cmsivolella/WiCharge-doc/esquematico_adafruit.png

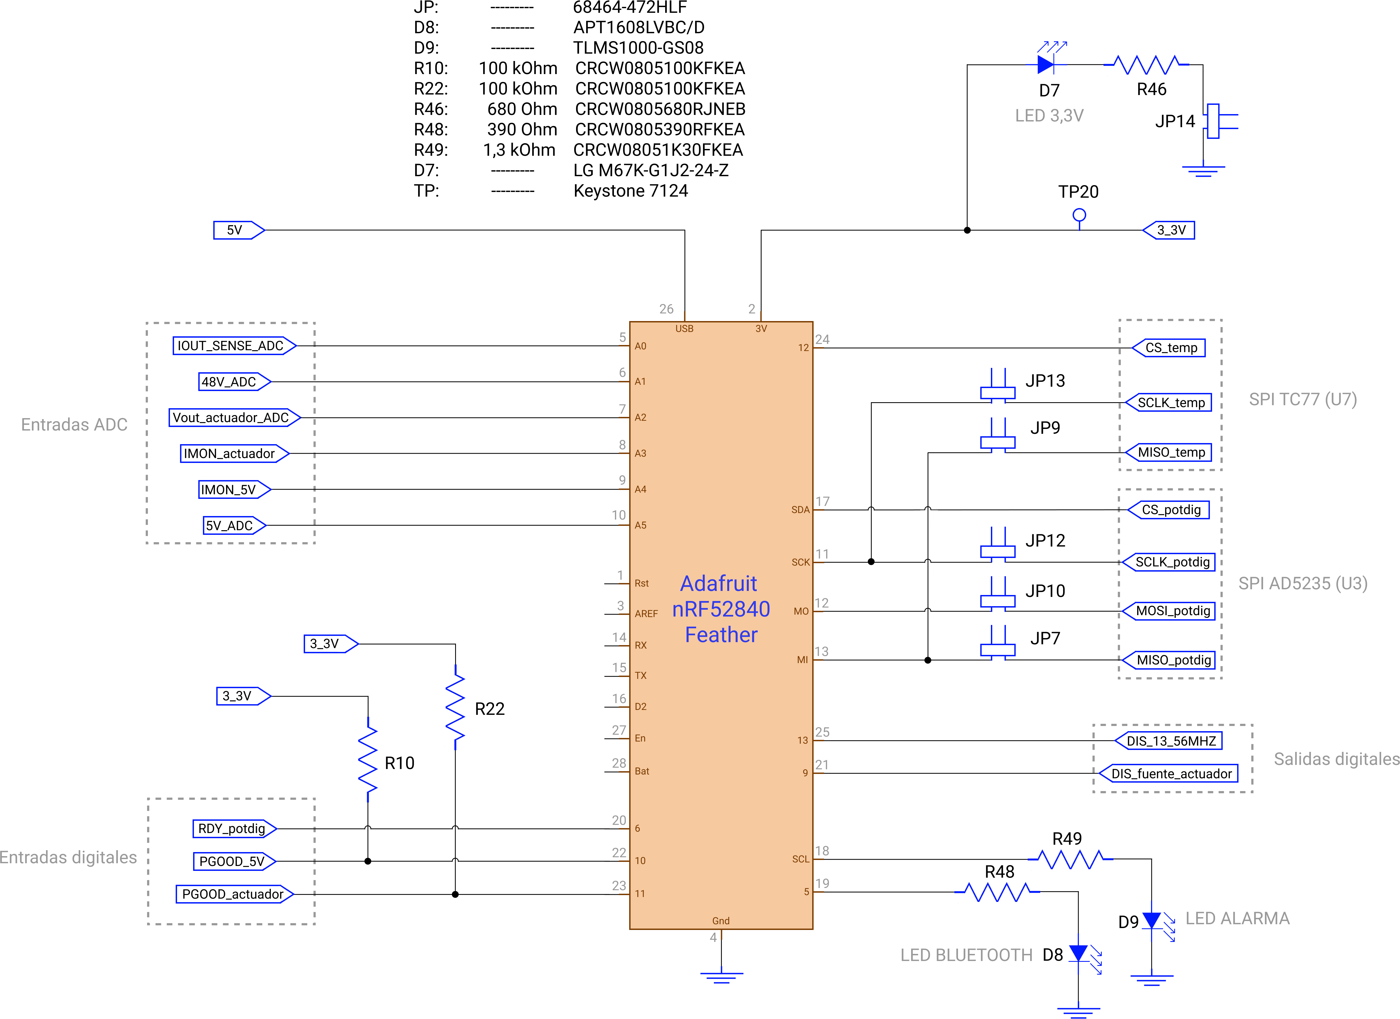
esquematico_adafruit.png
