cmsivolella/WiCharge-doc/esquematico_altonivel.png

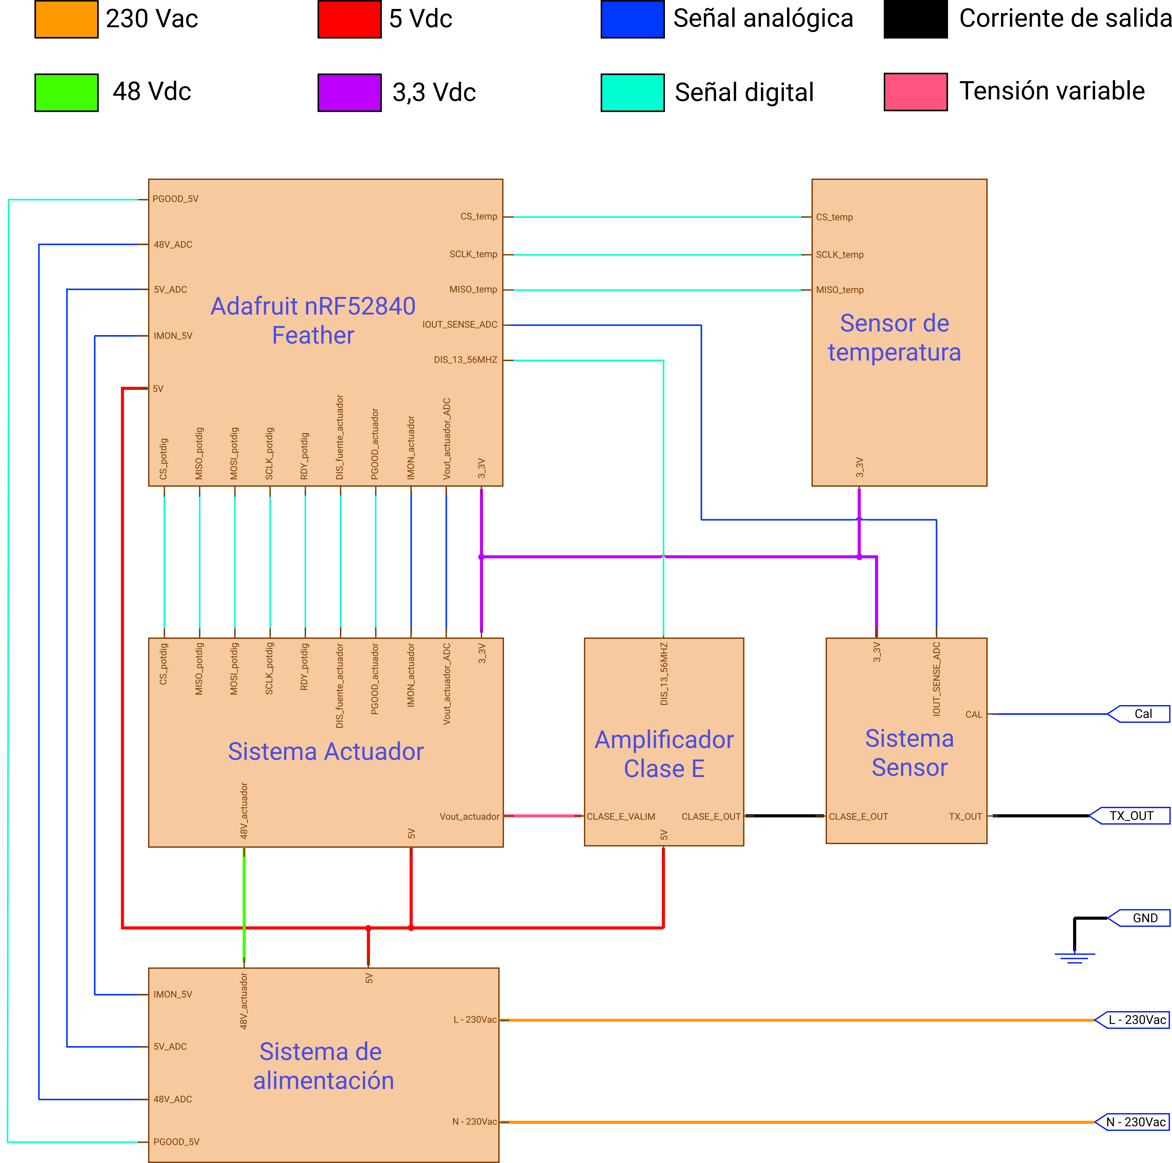
esquematico_altonivel.png
