cmsivolella/WiCharge-doc/esquematico_claseE.png

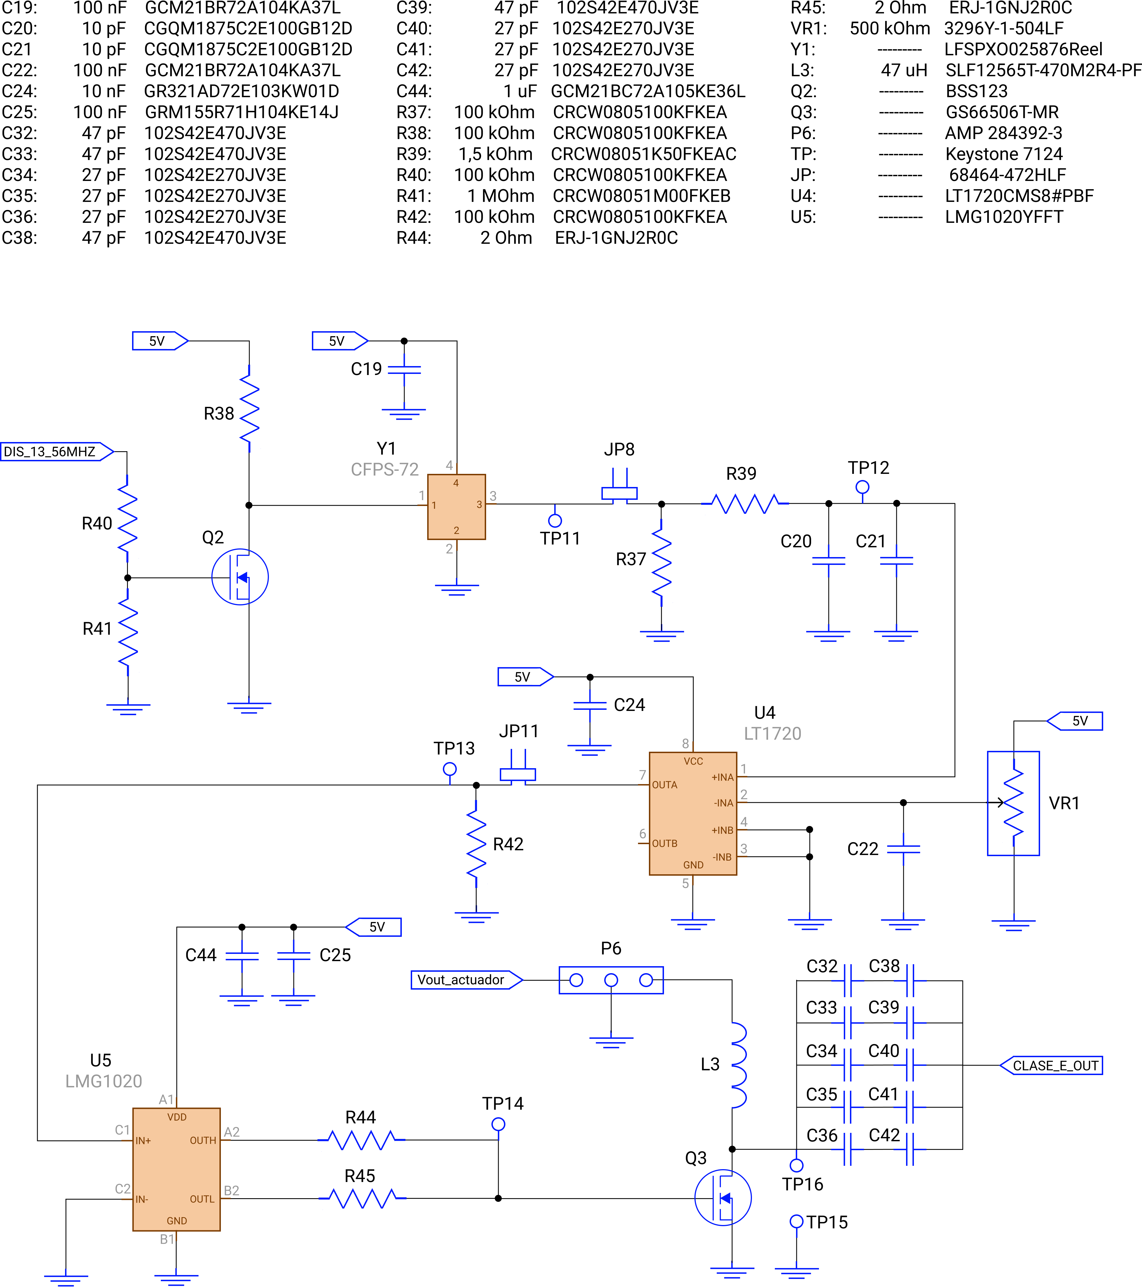
esquematico_claseE.png
