cmsivolella/WiCharge-doc/esquematico_sensortemperatura.png

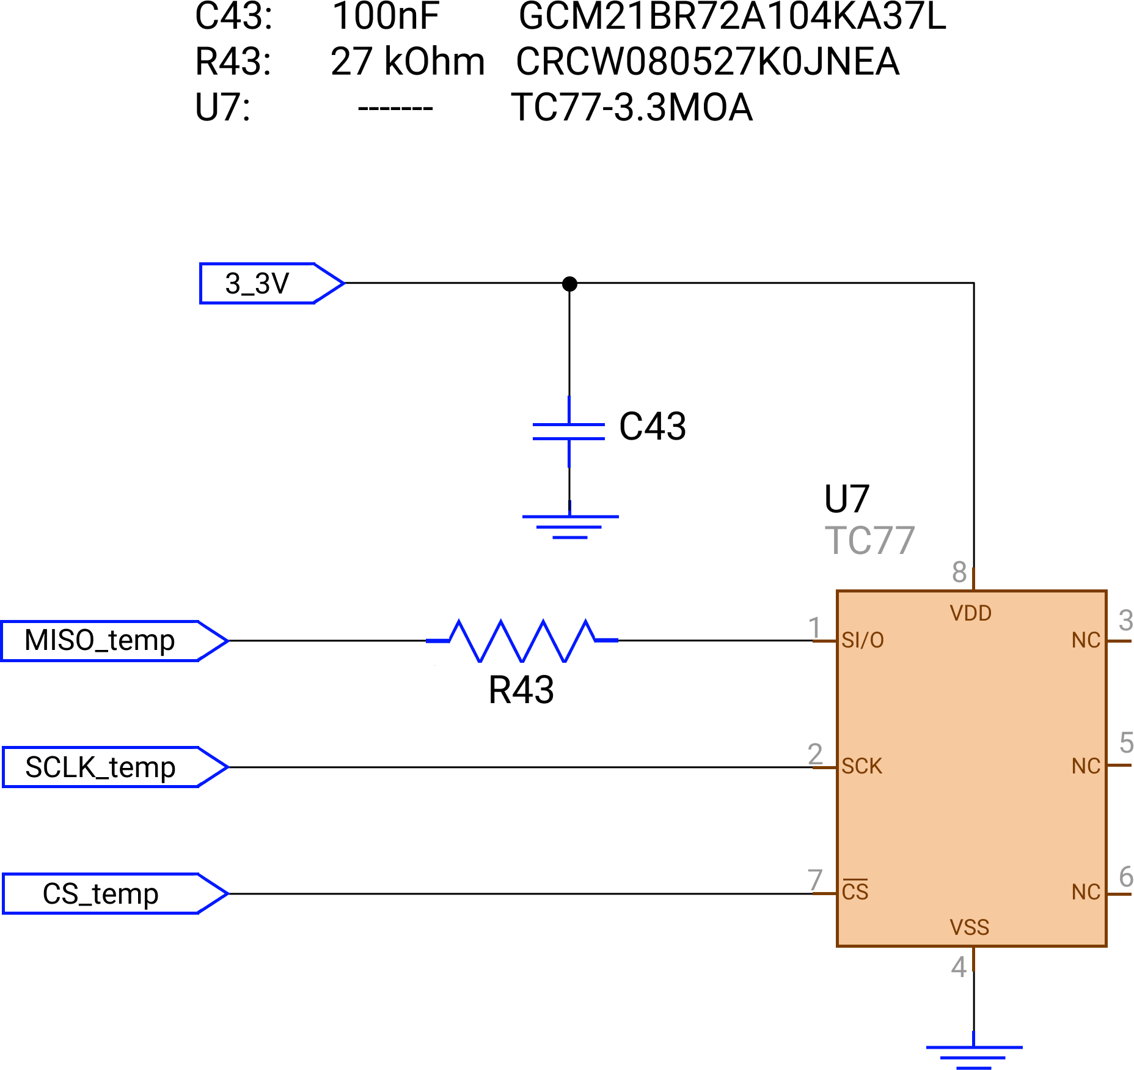
esquematico_sensortemperatura.png
