cmsivolella/WiCharge-doc/esquematico_sissensor_sincarga.png

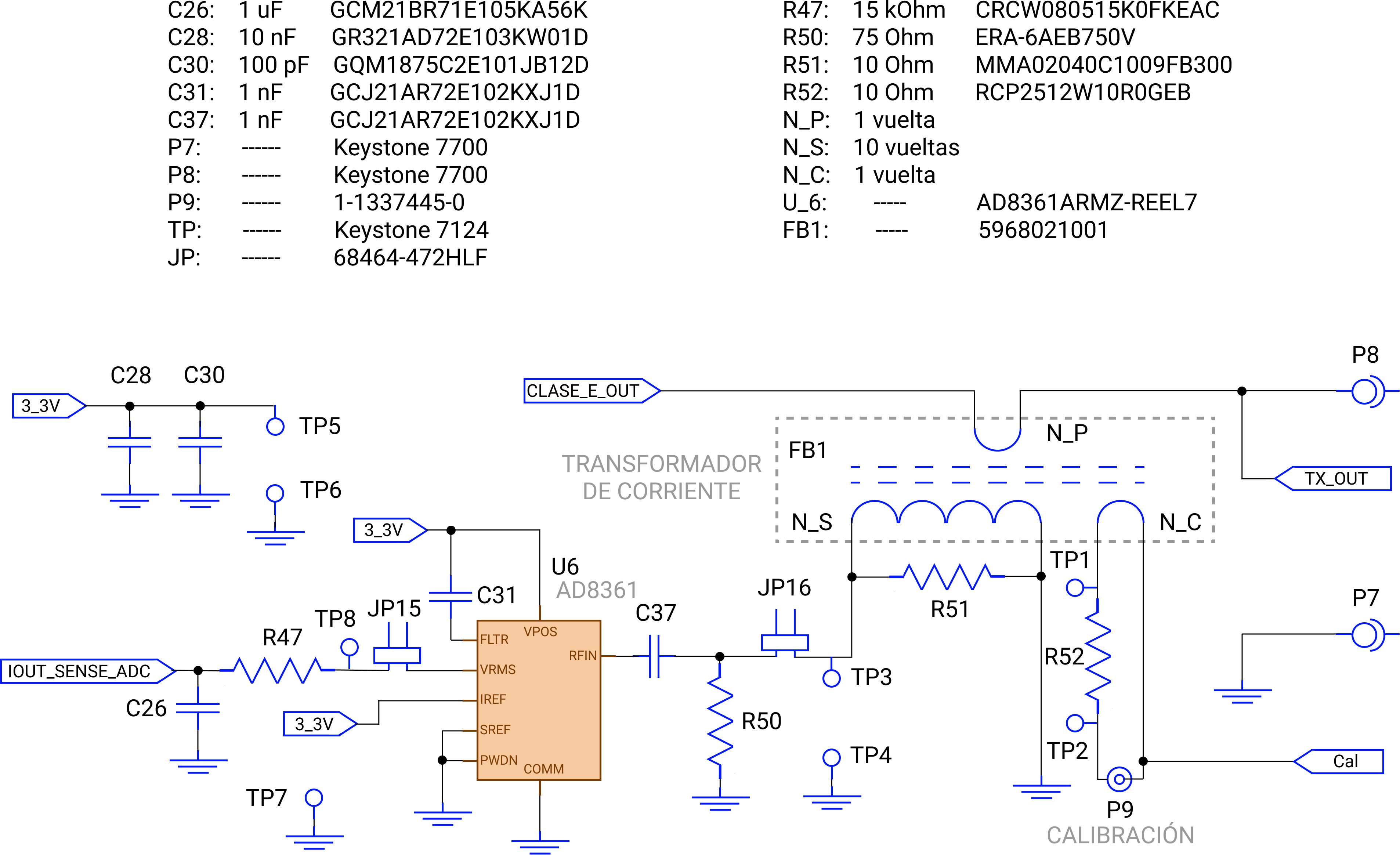
esquematico_sissensor_sincarga.png
