cmsivolella/WiCharge-doc/esquematicocompleto_alimentacion.png

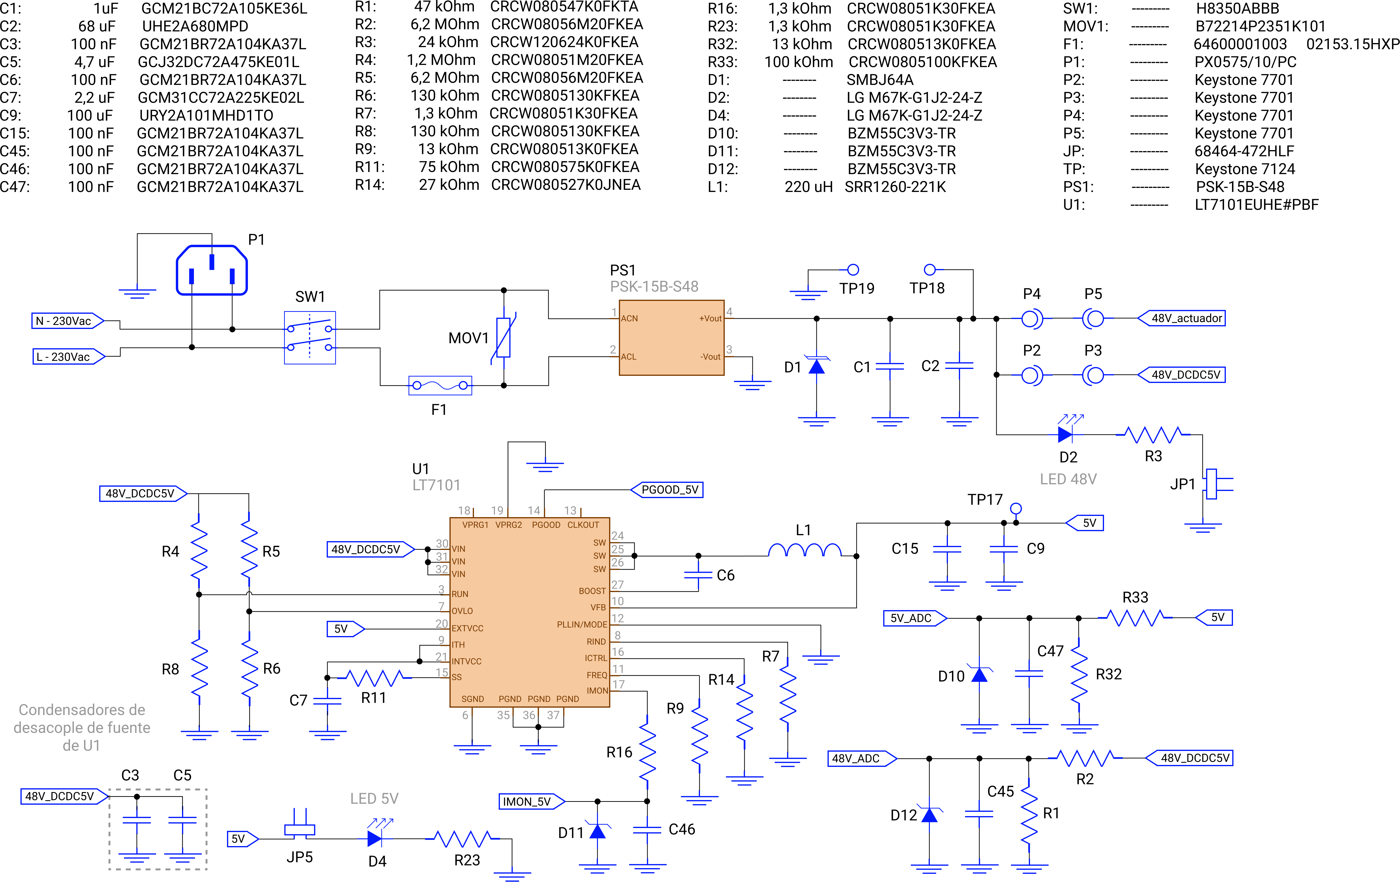
esquematicocompleto_alimentacion.png
