cmsivolella/WiCharge-doc/esquematicocompleto_sisactuador.png

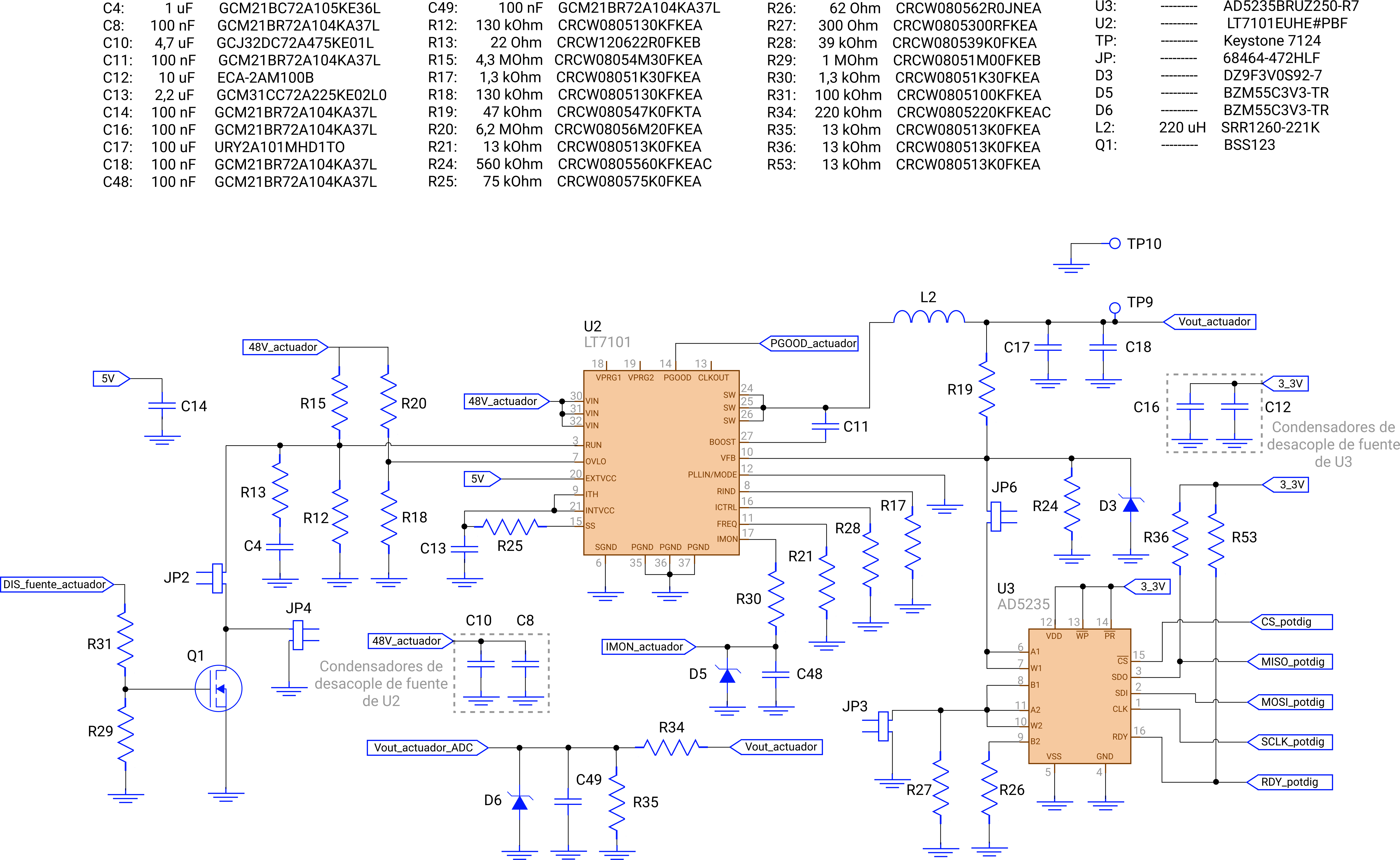
esquematicocompleto_sisactuador.png
