cmsivolella/WiCharge-doc/part_list(BOM)_wecharge_23_3_2021.xlsx

Line # | Description | Designator | Quantity | Type | Manufacturer name | Manufacturer part number | Distributor Name | Distributor part number | Link to distributor part | Package
1 | SMD Capacitor X7S(EIA) with Capacitance: 1.0uF Tol. 10%. Rated Voltage: 100Vdc | C1, C4, C44 | 3 | SMD | Murata | GCM21BC72A105KE36L | Digikey | 490-14436-1-ND | https://www.digikey.es/products/es?keywords=490-14436-1-ND | 0805
2 | SMD Capacitor X7R(EIA) with Capacitance: 0.10uF Tol. 10%. Rated Voltage: 100Vdc | C3, C6, C8, C11, C14, C15, C16, C18, C19, C22, C26, C31, C43, C45, C46, C47, C48, C49 | 18 | SMD | Murata | GCM21BR72A104KA37L | Digikey | 490-4789-1-ND | https://www.digikey.es/products/es?keywords=490-4789-1-ND | 0805
3 | SMD Capacitor X7S(EIA) with Capacitance: 4.7uF Tol. 10%. Rated Voltage: 100Vdc | C5, C10 | 2 | SMD | Murata | GCJ32DC72A475KE01L | Mouser | 81-GCJ32DC72A475K1L | https://www.mouser.com/ProductDetail/Murata-Electronics/GCJ32DC72A475KE01L?qs=dNBNMwHp2UAciZQOYiVaQg%3D%3D | 1210
4 | SMD Capacitor X7S(EIA) with Capacitance: 2.2uF Tol. 10%. Rated Voltage: 100Vdc | C7, C13 | 2 | SMD | Murata | GCM31CC72A225KE02L | Digikey | 490-14438-1-ND | https://www.digikey.es/products/es?keywords=490-14438-1-ND | 1206
5 | SMD Capacitor C0G(EIA) with Capacitance: 10pF Tol. 2%. Rated Voltage: 250Vdc | C20, C21 | 2 | SMD | Murata | GQM1875C2E100GB12D | Digikey | 490-8119-1-ND | https://www.digikey.es/products/es?keywords=490-8119-1-ND | 0603
6 | 10000pF ±10% 250V Capacitores cerámicos X7T 0805 (2012 métrico) | C24, C28 | 2 | SMD | Murata | GR321AD72E103KW01D | Digikey | 490-5717-2-ND | https://www.digikey.es/short/83m040d7 | 0805
7 | SMD capacitor X7R(EIA) with capacitance 0.10uF Tol.10%. Rated voltage 50Vdc 125C | C25 | 1 | SMD | Murata | GRM155R71H104KE14J | Digikey | 490-13342-1-ND | https://www.digikey.es/products/es?keywords=490-13342-1-ND | 0402
8 | SMD capacitor C0G(EIA) with capacitance 100pF Tol.5%. Rated voltage 250Vdc 125C | C30 | 1 | SMD | Murata | GQM1875C2E101JB12D | Digikey | 490-7173-1-ND | https://www.digikey.es/products/es?keywords=490-7173-1-ND | 0603
9 | Cap 47pF 1111 | C32, C33, C38, C39 | 4 | SMD | Johanson Technology | 102S42E470JV3E | Mouser | 609-102S42E470JV3E | https://www.mouser.com/ProductDetail/Johanson-Technology/102S42E470JV3E?qs=JSMYezppt248sgKCm%2F2bSQ%3D%3D | 1111
10 | Cap 27pF 1111 | C34, C35, C40, C41 | 4 | SMD | Johanson Technology | 102S42E270JV3E | Digikey | 609-102S42E270JV3E | https://www.mouser.com/ProductDetail/Johanson-Technology/102S42E270JV3E?qs=JSMYezppt25xAdbROaz%252Bwg%3D%3D | 1111
11 | SMD Capacitor X7R(EIA) with Capacitance: 1000pF Tol. 10%. Rated Voltage: 250Vdc | C37 | 1 | SMD | Murata | GCJ21AR72E102KXJ1D | Digikey | 490-5589-1-ND | https://www.digikey.es/products/es?keywords=490-5589-1-ND | 0805
12 | TVS diode 64V 103V SMB | D1 | 1 | SMD | Bourns Inc | SMBJ64A | Digikey | SMBJ64ABCT-ND | https://www.digikey.es/products/es?keywords=SMBJ64ABCT-ND | DO-214AA, SMD
13 | LED GREEN | D2, D4, D7 | 3 | SMD | OSRAM | LG M67K-G1J2-24-Z | Digikey | 475-1406-1-ND | https://www.digikey.es/products/es?keywords=475-1406-1-ND | 2-SMD, J conductores
14 | LED BLUE CLEAR 2SMD 0603 | D8 | 1 | SMD | Kingbright | APT1608LVBC/D | Digikey | 754-1933-1-ND | https://www.digikey.com/es/products/detail/kingbright/APT1608LVBC-D/5177434 | 0603
15 | Red 628nm LED Indication - Discrete 1.8V 0603 _1608 Metric_ | D9 | 1 | SMD | Vishay Semiconductor | TLMS1000-GS08 | Digikey | TLMS1000-GS08CT-ND | https://www.digikey.es/products/es?keywords=TLMS1000-GS08CT-ND | 0603 Vishay
16 | Diode Zener 3.0V 200mW | D3 | 1 | SMD | Diodes Incorporated | DZ9F3V0S92-7 | Digikey | DZ9F3V0S92-7DICT-ND | https://www.digikey.com/short/bw947wtv | SOD-923
17 | Diode Zener 3.3V 500mW | D5, D6, D10, D11, D12 | 5 | SMD | Vishay General Semiconductor | BZM55C3V3-TR | Digikey | 112-BZM55C3V3-CT-ND | https://www.digikey.com/short/jhr3nt79
18 | FIXED IND 220UH 1.38A 380MOHM SM | L1, L2 | 2 | SMD | Bourns Inc | SRR1260-221K | Digikey | SRR1260-221KCT-ND | https://www.digikey.es/product-detail/es/bourns-inc/SRR1260-221K/SRR1260-221KCT-ND/2127412 | Nonstandard
19 | Inductor 47 uH | L3 | 1 | SMD | TDK Corporation | SLF12565T-470M2R4-PF | Digikey | 445-10541-1-ND | https://www.digikey.es/products/es?keywords=445-10541-1-ND | Nonstandard
20 | Connector Terminal Block 3P | P6 | 1 | Through Hole | TE Connectivity AMP Connectors | 284392-3 | Digikey | A98167-ND | https://www.digikey.com/short/29f5bf12 | Through Hole
21 | BNC | P9 | 1 | Through Hole | TE Connectivity AMP Connectors | 1-1337445-0 | Digikey | A101972-ND | https://www.digikey.com/short/h4qffpfh | Through Hole
22 | N-Channel 100V 170mA _Ta_ 360mW _Ta_ Surface Mount SOT-23-3 | Q1, Q2 | 2 | SMD | ON Semiconductor | BSS123 | Digikey | BSS123NCT-ND | https://www.digikey.es/products/es?keywords=BSS123NCT-ND | SOT-23 ON Semiconductor
23 | GAN TRANS E-MODE 650V TOP SIDE COOL | Q3 | 1 | SMD | Gan Systems | GS66506T-MR | Mouser | 499-GS66506T-MR | https://www.mouser.com/ProductDetail/GaN-Systems/GS66506T-MR | DIE
24 | 130 kohm, 125 mW, - 1%, 150 V Surface Mount Thick Film Resistor, AEC-Q200 CRCW Series, | R6, R8, R12, R18 | 4 | SMD | Vishay Dale | CRCW0805130KFKEA | Digikey | 541-130KCCT-ND | https://www.digikey.es/products/es?keywords=541-130KCCT-ND | 0805
25 | 6.2 MOhms Â±1% 0.125W, 1/8W Chip Resistor 0805 (2012 Metric) Automotive AEC-Q200 Thick Film | R2, R5, R20 | 3 | SMD | Vishay | CRCW08056M20FKEA | Digikey | 541-6.20MCCT-ND | https://www.digikey.es/products/es?keywords=541-6.20MCCT-ND | 0805
26 | Res Thick Film 1206 24K Ohm 1% 0.25W(1/4W) Â±100ppm/C Molded SMD Automotive Paper T/R | R3 | 1 | SMD | Vishay Dale | CRCW120624K0FKEA | Digikey | 541-24.0KFCT-ND | https://www.digikey.es/products/es?keywords=541-24.0KFCT-ND | 1206
27 | 1.2 MOhms Â±1% 0.125W, 1/8W Chip Resistor 0805 (2012 Metric) Automotive AEC-Q200 Thick Film | R4 | 1 | SMD | Vishay | CRCW08051M20FKEA | Digikey | 541-1.20MCCT-ND | https://www.digikey.es/products/es?keywords=541-1.20MCCT-ND | 0805
28 | 1.3 kOhms Â±1% 0.125W, 1/8W Chip Resistor 0805 (2012 Metric) Automotive AEC-Q200 Thick Film | R7, R16, R17, R30, R49 | 5 | SMD | Vishay Dale | CRCW08051K30FKEA | Digikey | 541-1.30KCCT-ND | https://www.digikey.es/products/es?keywords=541-1.30KCCT-ND | 0805
29 | 13 kOhms Â±1% 0.125W, 1/8W Chip Resistor 0805 (2012 Metric) Automotive AEC-Q200 Thick Film | R9, R21, R23, R32, R35, R36, R53 | 7 | SMD | Vishay Dale | CRCW080513K0FKEA | Digikey | 541-13.0KCCT-ND | https://www.digikey.es/products/es?keywords=541-13.0KCCT-ND | 0805
30 | 100 kOhms Â±1% 0.125W, 1/8W Chip Resistor 0805 _2012 Metric_ Automotive AEC-Q200 Thick Film | R10, R22, R31, R33, R37, R38, R40, R42 | 8 | SMD | Vishay | CRCW0805100KFKEA | Digikey | 541-100KCCT-ND | https://www.digikey.es/products/es?keywords=541-100KCCT-ND | 0805
31 | 75 kOhms Â±1% 0.125W, 1/8W Chip Resistor 0805 (2012 Metric) Automotive AEC-Q200 Thick Film | R11, R25 | 2 | SMD | Vishay Dale | CRCW080575K0FKEA | Digikey | 541-75.0KCCT-ND | https://www.digikey.es/products/es?keywords=541-75.0KCCT-ND | 0805
32 | Res Thick Film 1206 22 Ohm 1% 0.25W(1/4W) Â±100ppm/Â°C Pad SMD Automotive T/R | R13 | 1 | SMD | Vishay | CRCW120622R0FKEB | Digikey | 541-CRCW120622R0FKEBCT-ND | https://www.digikey.es/products/es?keywords=541-CRCW120622R0FKEBCT-ND | 1206
33 | 32.4 kOhms Â±1% 0.125W, 1/8W Chip Resistor 0805 (2012 Metric) Automotive AEC-Q200 Thick Film | R28 | 1 | SMD | Vishay | CRCW080532K4FKEA | Digikey | 541-32.4KCCT-ND | https://www.digikey.es/short/5f0w90zc | 0805
34 | 4.3 MOhms Â±1% 0.125W, 1/8W Chip Resistor 0805 (2012 Metric) Automotive AEC-Q200 Thick Film | R15 | 1 | SMD | Vishay | CRCW08054M30FKEA | Digikey | 541-4.30MCCT-ND | https://www.digikey.es/products/es?keywords=541-4.30MCCT-ND | 0805
35 | 47 KOhms 1/8W Chip Resistor 0805 (2012 Metric) | R1, R19 | 2 | SMD | Vishay | CRCW080547K0FKTA | Digikey | 541-3026-1-ND | https://www.digikey.com/short/5czwfdhf | 0805
36 | Res Thick Film 0805 220K Ohm 1% 0.125W(1/8W) Â±100ppm/Â°C Pad SMD T/R | R24, R34 | 2 | SMD | Vishay | CRCW0805220KFKEAC | Digikey | 541-CRCW0805220KFKEACCT-ND | https://www.digikey.es/products/es?keywords=541-CRCW0805220KFKEACCT-ND | 0805
37 | Res Thick Film 0805 56 Ohm | R26 | 1 | SMD | Vishay | CRCW080556R0JNEA | Digikey | 541-56ACT-ND | https://www.digikey.com/short/z21m5fmn | 0805
38 | Res Thick Film 0805 390 Ohm | R27 | 1 | SMD | Vishay | CRCW0805390RFKEA | Digikey | 541-390CCT-ND | https://www.digikey.com/short/mb8p7p5h | 0805
39 | 1 MOhms Â±1% 0.125W, 1/8W Chip Resistor 0805 (2012 Metric) Automotive AEC-Q200 Thick Film | R29, R41 | 2 | SMD | Vishay Dale | CRCW08051M00FKEB | Digikey | 541-CRCW08051M00FKEBCT-ND | https://www.digikey.es/products/es?keywords=541-CRCW08051M00FKEBCT-ND | 0805
40 | 1.5 kOhms Â±1% 0.125W, 1/8W Chip Resistor 0805 _2012 Metric_ Thick Film | R39, R47 | 2 | SMD | Vishay | CRCW08051K50FKEAC | Digikey | 541-4161-1-ND | https://www.digikey.es/products/es?keywords=541-4161-1-ND | 0805
41 | 680 Ohms Â±1% 0.125W, 1/8W Chip Resistor 0805 _2012 Metric_ Thick Film | R46 | 1 | SMD | Vishay | CRCW0805680RJNEB | Digikey | 541-CRCW0805680RJNEBCT-ND | https://www.digikey.com/en/products/detail/vishay-dale/CRCW0805680RJNEB/5075830 | 0805
42 | 390 Ohms Â±1% 0.125W, 1/8W Chip Resistor 0805 _2012 Metric_ Thick Film | R48 | 1 | SMD | Vishay | CRCW0805390RFKEA | Digikey | 541-390CCT-ND | https://www.digikey.com/en/products/detail/vishay-dale/CRCW0805390RFKEA/1175589 | 0805
43 | 27 kOhms 1/8W 0805 | R14, R43 | 2 | SMD | Vishay | CRCW080527K0JNEA | Digikey | 541-27KACT-ND | https://www.digikey.com/short/rbd88rwm | 0805
44 | RES SMD 2 OHM 5% 1/20W 0201 | R44, R45 | 2 | SMD | Panasonic Electronic Components | ERJ-1GNJ2R0C | Digikey | P123293CT-ND | https://www.digikey.com/short/nrq3bpb0 | 0201
45 | Res Thin Film 0805 75 Ohm 0.1% 0.125W(1/8W) Ã˜Â¢Â±25ppm/Ã˜Â¢Â°C Molded SMD Automotive Punched T/R | R50 | 1 | SMD | Panasonic Electronic Components | ERA-6AEB750V | Digikey | P75DACT-ND | https://www.digikey.es/products/es?keywords=P75DACT-ND | 0805
46 | Resistor MELF 0.4W 0204 2.7 Ohm | R51 | 1 | SMD | Vishay | MMA02040C2708FB300 | Digikey | MMA-2.7ACT-ND | https://www.digikey.es/short/8mh98jj9 | 0204
47 | Resistor 10 Ohm RPC 2512 | R52 | 1 | SMD | Vishay | RCP2512W10R0GEB | Digikey | 541-RCP2512W10R0GEBTR-ND | https://www.digikey.com/short/02918j7r | 2512
48 | 105V, 2.3A, L EMI SYNC BUCK REG | U1, U2 | 2 | SMD | Analog Devices Inc | LT7101EUHE#PBF | Digikey | LT7101EUHE#PBF-ND | https://www.digikey.es/products/es?keywords=LT7101EUHE%23PBF-ND | 36-WFQFN, 26 Leads, Exposed pad
49 | 250kOhmDigital Potentiometer 1024POS Non-Volatile Linear/Log 16-Pin TSSOP T/R | U3 | 1 | SMD | Analog Devices | AD5235BRUZ250-R7 | Digikey | AD5235BRUZ250-R7CT-ND | https://www.digikey.es/products/es?keywords=AD5235BRUZ250-R7CT-ND | TSSOP-16 Analog Devices
50 | Linear IC - Comparator Linear Technology LT1720CMS8#PBF Multi-purpose CMOS, Rail-to-rail, TTL MSOP 8 | U4 | 1 | SMD | Linear Technology/Analog | LT1720CMS8#PBF | Digikey | LT1720CMS8#PBF-ND | https://www.digikey.es/products/es?keywords=LT1720CMS8%23PBF-ND | MSOP-8 Linear Technology/Analog
51 | 5V, 7A/5A low side GaN driver with 60MHz/1ns speed 6-DSBGA -40 to 125 | U5 | 1 | SMD | Texas Instruments | LMG1020YFFT | Digikey | 296-50209-1-ND | https://www.digikey.es/products/es?keywords=296-50209-1-ND | DSBGA-6 Texas Instruments
52 | RF Detector IC Cellular, CDMA, W-CDMA 2.5GHz 0 ~ 700mV Â±0.25dB 8-TSSOP, 8-MSOP (0.118, 3.00mm Width) | U6 | 1 | SMD | Analog devices | AD8361ARMZ-REEL7 | Digikey | AD8361ARMZ-REEL7CT-ND | https://www.digikey.es/products/es?keywords=AD8361ARMZ-REEL7CT-ND | MSOP-8 Analog Devices
53 | Temperature Sensor Digital, Local -55Â°C ~ 125Â°C 12 b 8-SOIC | U7 | 1 | SMD | Microchip | TC77-3.3MOA | Digikey | TC77-3.3MOA-ND | https://www.digikey.es/products/es?keywords=TC77-3.3MOA-ND | SOIC-8 Microchip
54 | Crystal oscillator. | Y1 | 1 | SMD | IQD | LFSPXO025876Reel | Digikey | 1923-1769-1-ND | https://www.digikey.es/products/es?keywords=1923-1769-1-ND | 4-SMD, No Lead
55 | Fuse holder | F1 | 1 | Through Hole | Little Fuse | 64600001003 | Digikey | WK6244-ND | https://www.digikey.com/short/1fcpw23b | Through hole
