cmsivolella/WiCharge-doc/(commit log)

2021-07-19 Add files via upload
    Gerbers, centroid y BOM agregado
    [part_list(BOM)_wecharge_23_3_2021.xlsx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]
2021-07-19 Se agregan esquemáticos y plan de proyecto.
